blalor/furnace_monitor/eagle/furnace_monitor.brd.png

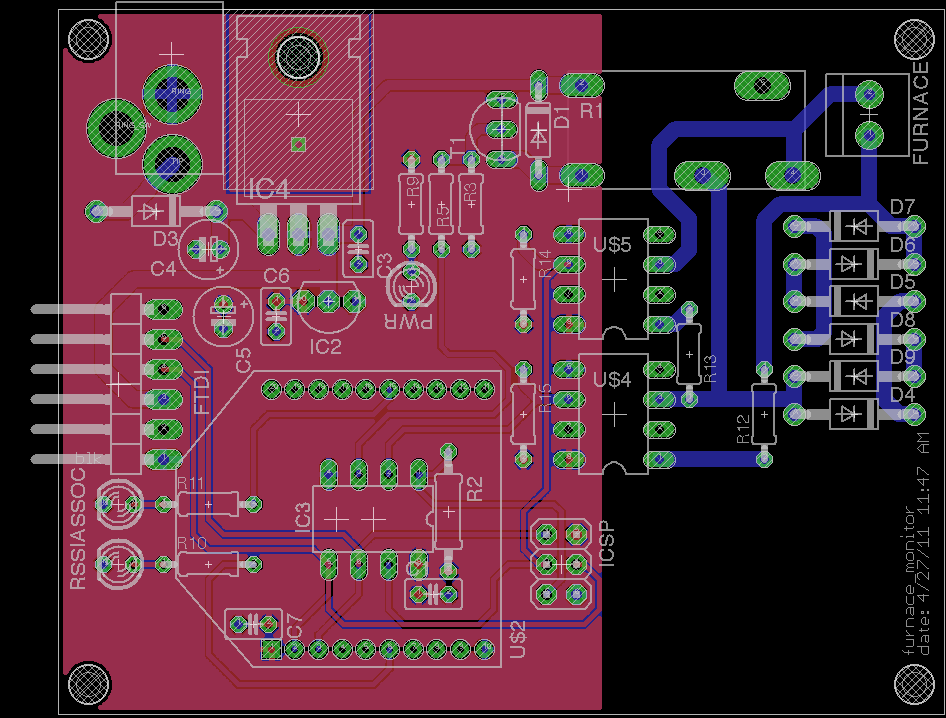
eagle/furnace_monitor.brd.png
