blalor/furnace_monitor/eagle/furnace_monitor.sch.png

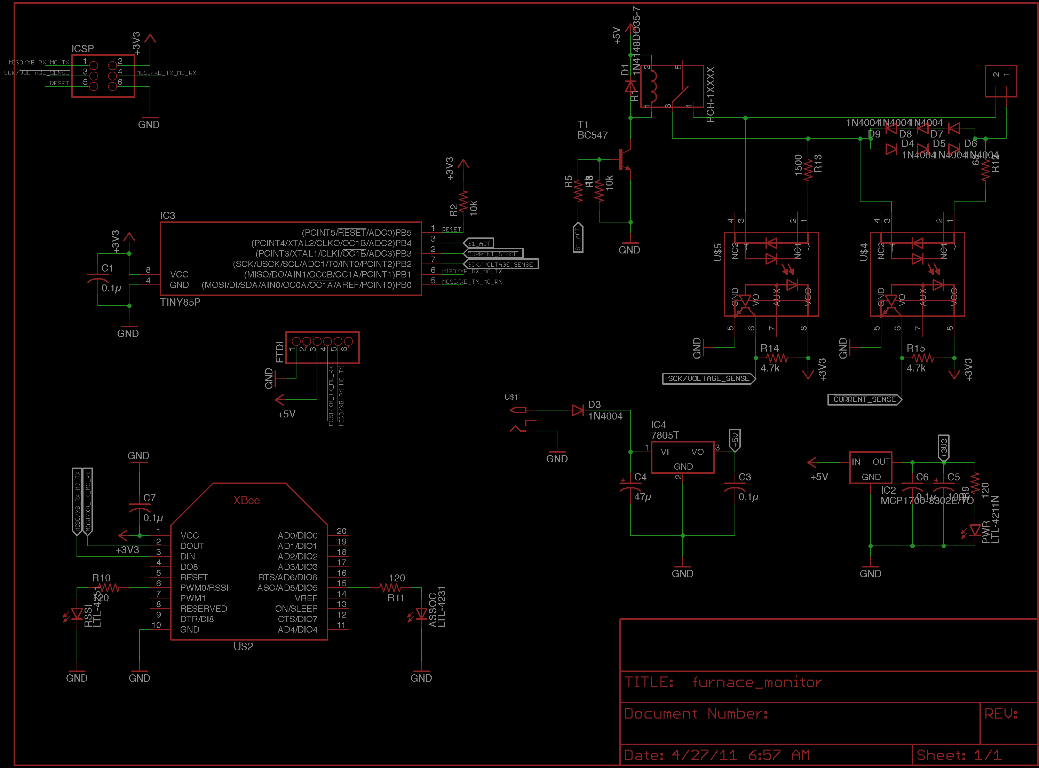
eagle/furnace_monitor.sch.png
