blalor/furnace_monitor/(commit log)

2011-04-27 Named and labelled parts, smashed labels on board.
    [furnace_monitor.brd, furnace_monitor.sch]
2011-04-27 Adding stop mask under voltage regulator
    Also tweaked export script.
    [furnace_monitor.brd]
2011-05-17 initial commit; have tests for relay
2011-05-17 tests for current sensor
2011-05-17 Adding USI Serial driver
    Copied from http://github.com/blalor/iswba
    Needs to be turned into a library, somehow.
2011-05-17 USISerial and Timer0 tests now pass
2011-05-17 Making baud rate configurable at runtime
    Even parity still hard-coded.
    Limited range of baud rates are available without configuring the timer
    prescaler at runtime.
2011-05-17 Implemented receiving without parity enabled
    Parity bit reception now configurable at runtime. Still not being checked…
2011-05-18 Implementing transmit routines
    Still not supporting parity…
2011-05-18 Adding parity bit calculation for TX
    Not very happy with this test; parity_even_bit is an optimized assembly macro
    in util/parity.h that I had to replicate locally. I *think* I got it right…
2011-05-18 linking in minimal printf implementation
2011-05-18 Adding timer1 driver and tests
    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
2011-05-18 Making timer1 tests pass
2011-05-19 Moved more code into scheduler_tick(), copious comments
    Trying to minimize number of times interrupts are disabled. Thinking that
    maybe the tick method should be stripped to just setting a flag, however…
2011-05-20 Removed floating-point ops for bit duration
    before: after:
    AVR Memory Usage AVR Memory Usage
    ---------------- ----------------
    Device: attiny85 Device: attiny85
    Program: 6264 bytes (76.5% Full) Program: 2906 bytes (35.5% Full)
    (.text + .data + .bootloader) (.text + .data + .bootloader)
    Data: 352 bytes (68.8% Full) Data: 88 bytes (17.2% Full)
    (.data + .bss + .noinit) (.data + .bss + .noinit)
    Holy. Shit. One "(float)"* cost 3358 bytes (40.9%) of program space and 264
    bytes (51.6%) of SRAM.
    * the initial_timer0_seed change was just styl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
2011-05-22 initial cut at furnace "controller"
2011-05-24 Extending serial_handler tests
    Exploring how it behaves when bad messages are sent. I don't love this
    protocol, but it should work…
2011-05-25 Adding cpu/64 prescaler, CTC for OCR1C
    • Need F_CPU/64 prescaler
    • timer1 supports clear-on-compare for OCR1C, but there's no associated
    interrupt. weird.
2011-05-25 correcting return type of usi_tx_byte, expanding controller
    • providing pointer to serial_handler_send in furnace_controller_init; allows
    controller to send messages
    • adding furnace_update_timer to be used as a scheduled task for updating the
    timer
    • furnace_handle_incoming_msg is provided as callback to serial_handler for
    processing incoming messages
2011-05-25 putting it all together
    need to confirm that the timer's working with the precision expected, but
    everything appears to be working!
2011-05-27 Fixing size of duration_seconds
    This will probably explain why starting the timer via a serial command didn't
    work…
2011-05-27 syncing Makefile with current source
2011-05-27 Adding a safety barrier to the timer duration
2011-05-27 adding utility to dump sample binary data
2011-05-27 PORTB != PINB. Uh, wow. Just … wow.
2011-05-27 Ensuring that the max timer value is allowed
